hsingchen-dev/LLM-YOLO-Robotic-Arm/Physical Robot/captured_20250410_202952_cup_boxed.jpg

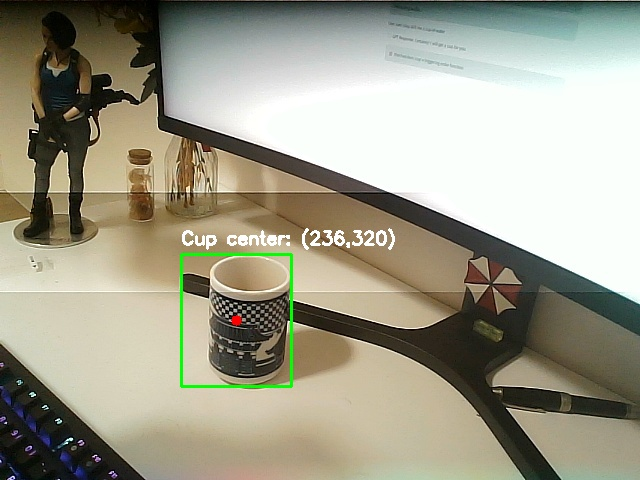
Physical Robot/captured_20250410_202952_cup_boxed.jpg
