hsingchen-dev/LLM-YOLO-Robotic-Arm/Physical Robot/edfa75bb21797ba52d6b21e9edcb2ea.jpg

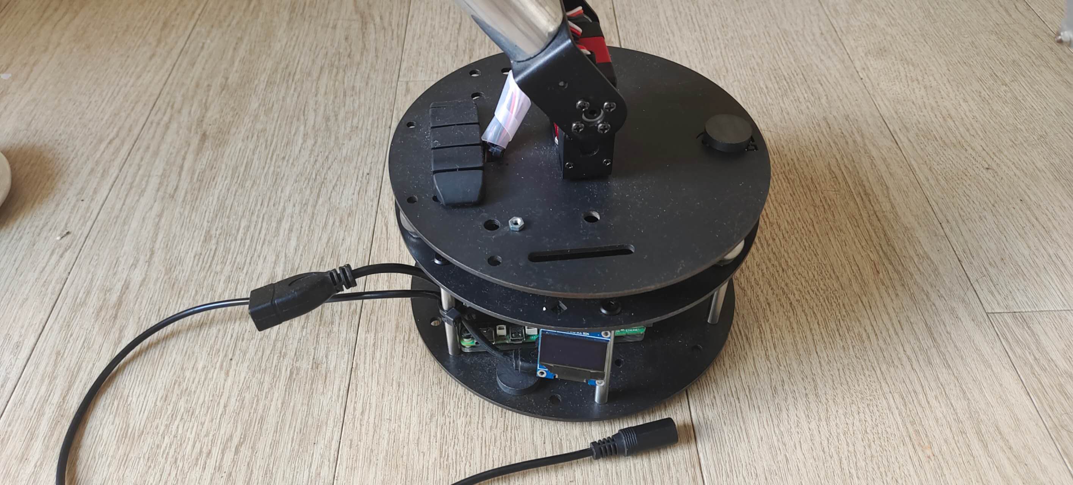
Physical Robot/edfa75bb21797ba52d6b21e9edcb2ea.jpg
