hsingchen-dev/LLM-YOLO-Robotic-Arm/3d图纸/1743786342963.png

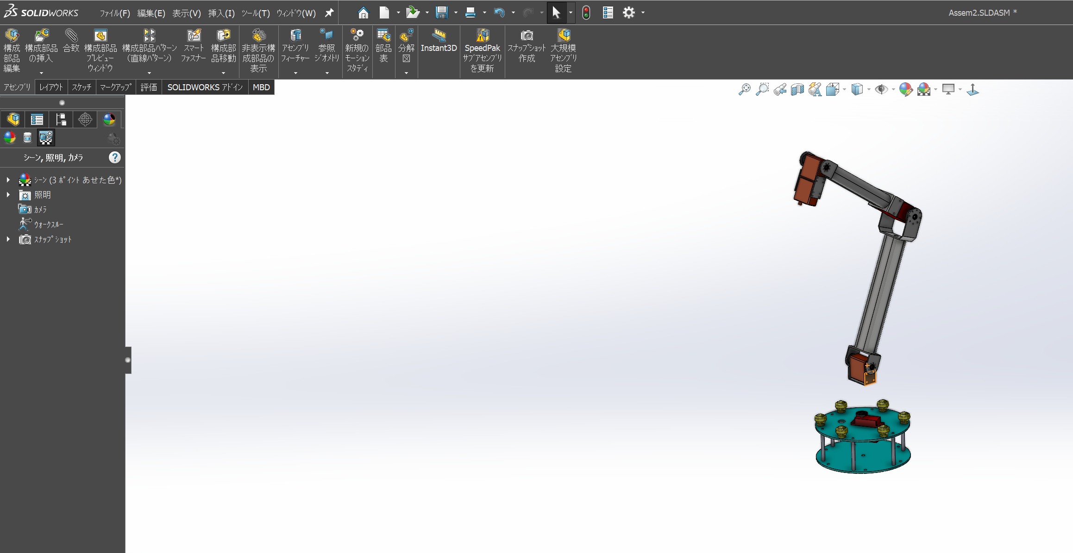
3d图纸/1743786342963.png
