hsingchen-dev/LLM-YOLO-Robotic-Arm/3d图纸/1743786404467.png

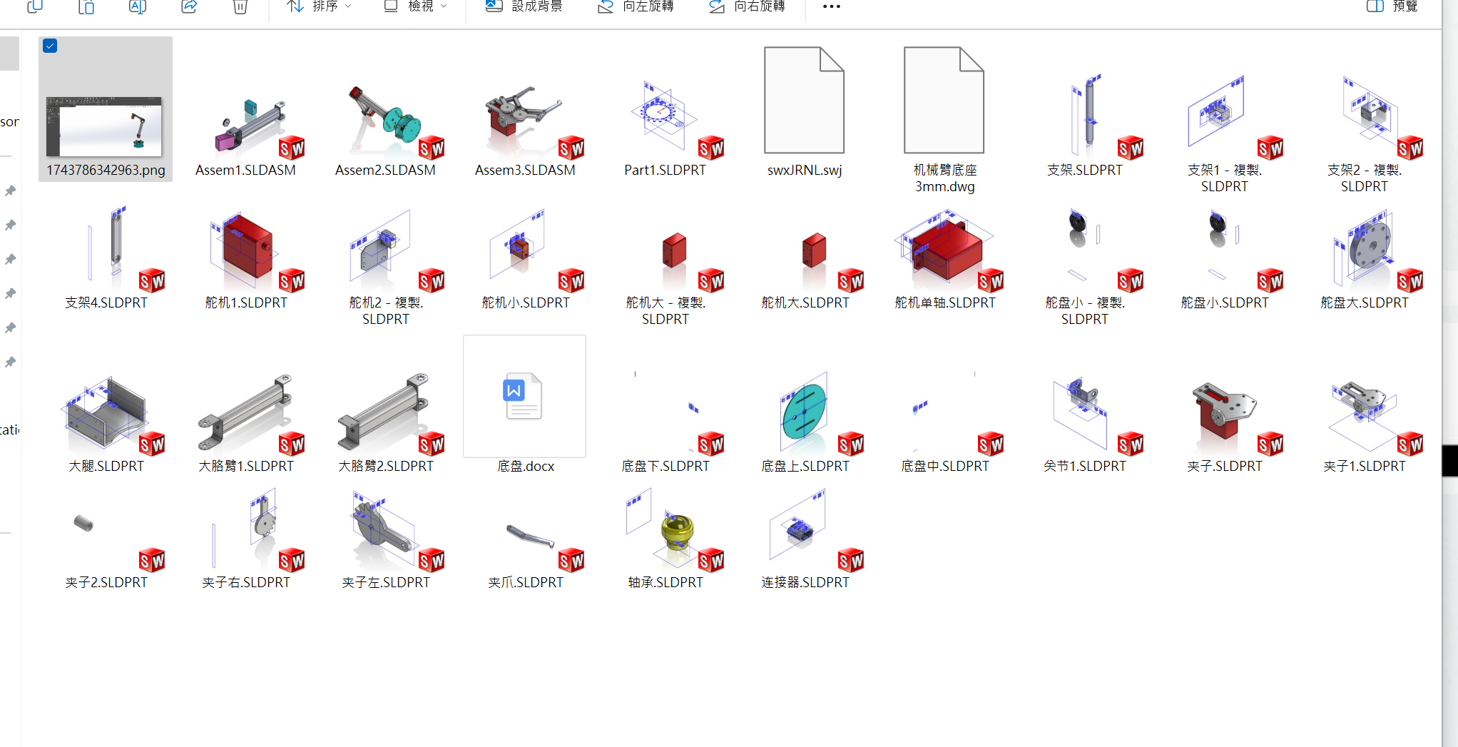
3d图纸/1743786404467.png
