hsingchen-dev/LLM-YOLO-Robotic-Arm/Physical Robot/3e01b9ee80491bdccdec591c8c2af41.jpg

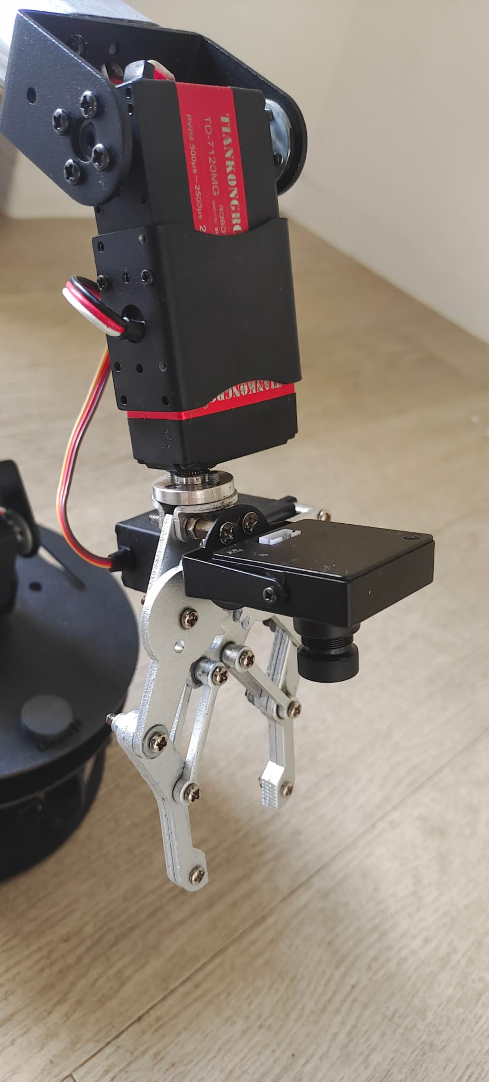
Physical Robot/3e01b9ee80491bdccdec591c8c2af41.jpg
