hsingchen-dev/LLM-YOLO-Robotic-Arm/Physical Robot/8b897eb83b60249cd29b728171771cb.jpg

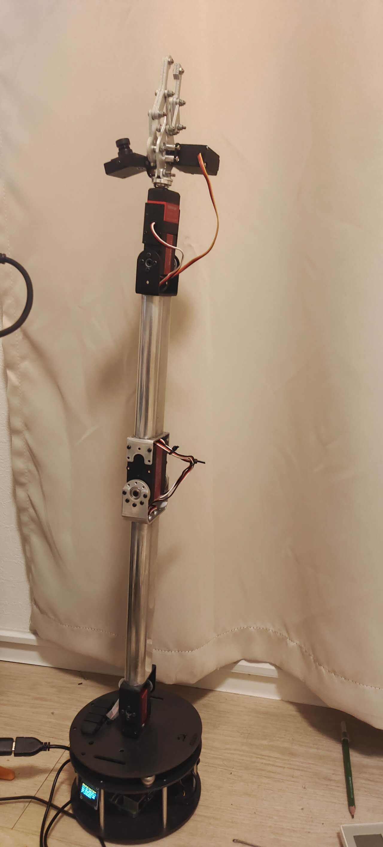
Physical Robot/8b897eb83b60249cd29b728171771cb.jpg
