hsingchen-dev/LLM-YOLO-Robotic-Arm/Physical Robot/5620d81eddff86d6492e32521e1b3c4.jpg

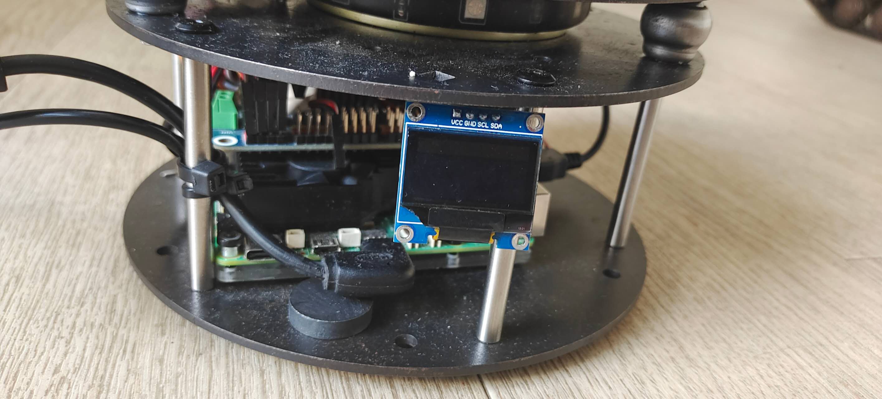
Physical Robot/5620d81eddff86d6492e32521e1b3c4.jpg
