hsingchen-dev/LLM-YOLO-Robotic-Arm/Physical Robot/c2f27f0e20178d3c40c21ab208498a1.jpg

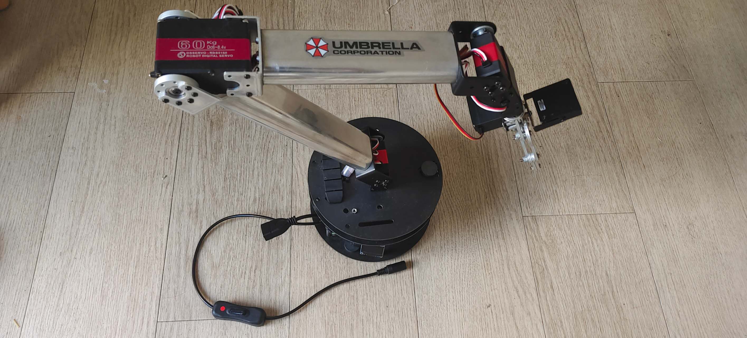
Physical Robot/c2f27f0e20178d3c40c21ab208498a1.jpg
