hsingchen-dev/LLM-YOLO-Robotic-Arm/Physical Robot/c7c526ec436b45697d2431747a68646.jpg

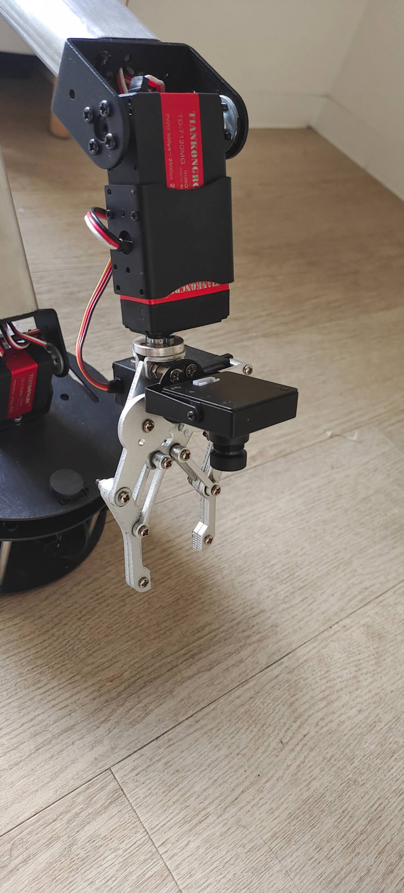
Physical Robot/c7c526ec436b45697d2431747a68646.jpg
