hsingchen-dev/LLM-YOLO-Robotic-Arm/Physical Robot/c12d59ae130f2f59f7dcb45b6c12473.jpg

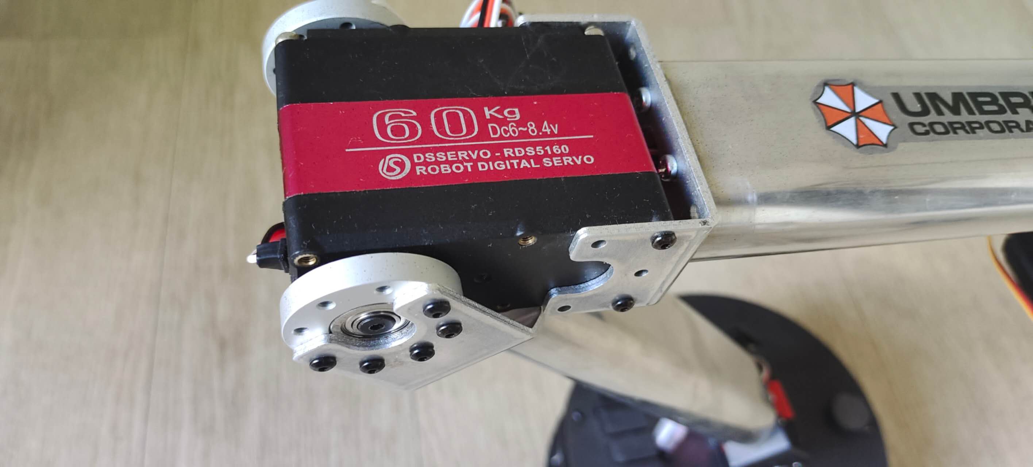
Physical Robot/c12d59ae130f2f59f7dcb45b6c12473.jpg
