hsingchen-dev/LLM-YOLO-Robotic-Arm/Physical Robot/cda66152f0cad378f4611de1aca18b9.png

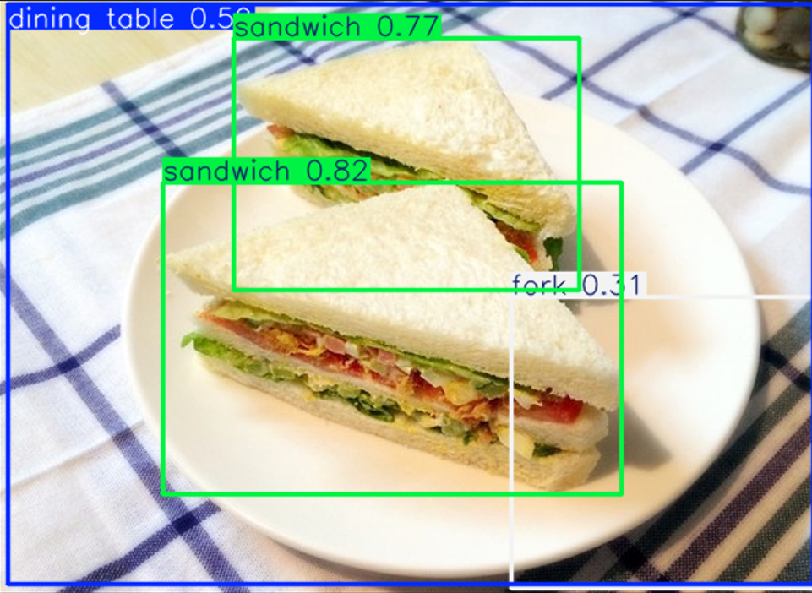
Physical Robot/cda66152f0cad378f4611de1aca18b9.png
