hsingchen-dev/LLM-YOLO-Robotic-Arm/Physical Robot/ee14b7436c1ae5e754dbd46fa025461.jpg

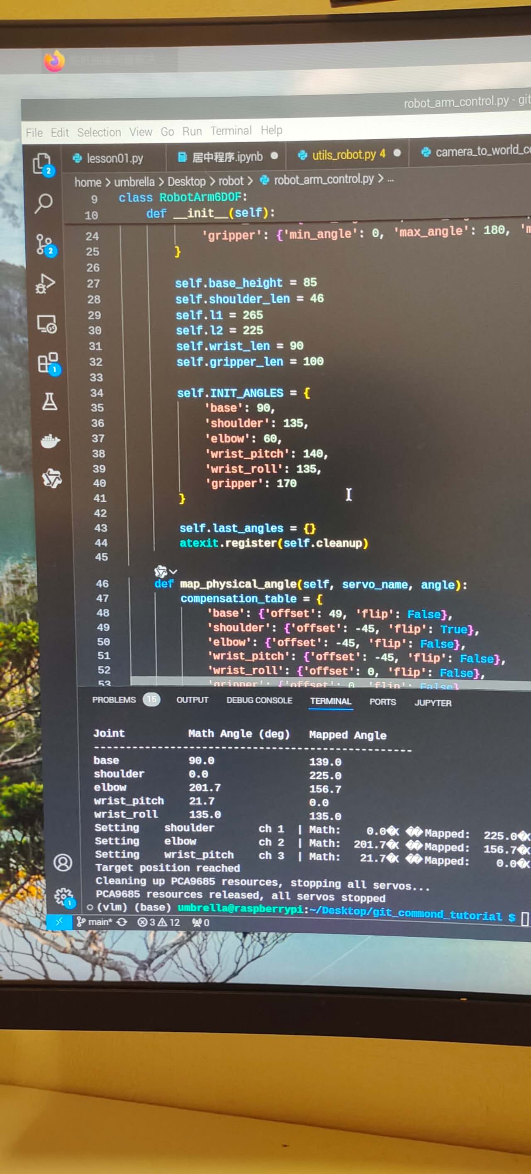
Physical Robot/ee14b7436c1ae5e754dbd46fa025461.jpg
