hsingchen-dev/LLM-YOLO-Robotic-Arm/3d图纸/Assem3.SLDASM

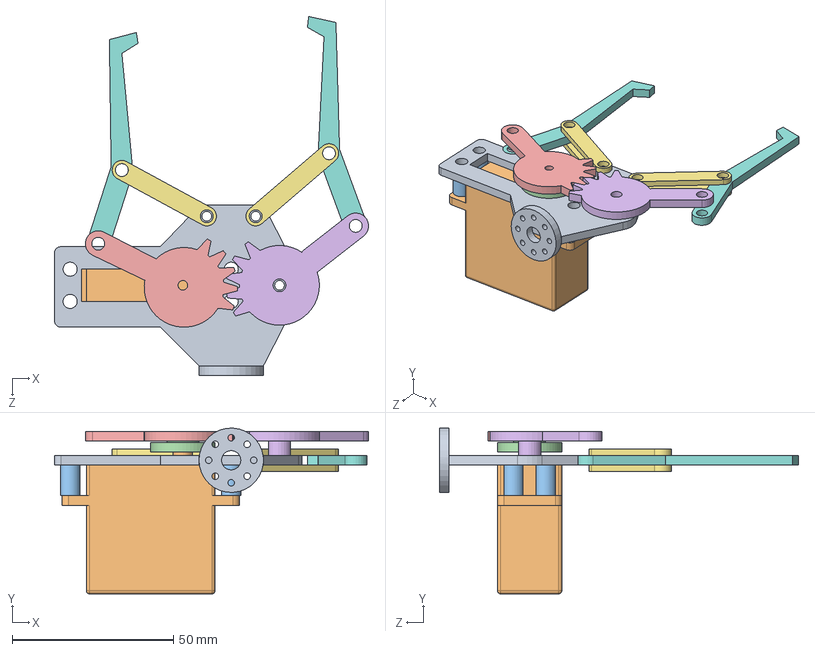
[picture p24: CAD file, 2025-03-27]
3d图纸/Assem3.SLDASM
97.5 x 51.5 x 111.5 mm
夹子1
舵机单轴
夹子2 x 4
舵盘小
夹子右
夹子左
支架4 x 4
夹爪 x 2
