hsingchen-dev/LLM-YOLO-Robotic-Arm/3d图纸/Assem2.SLDASM

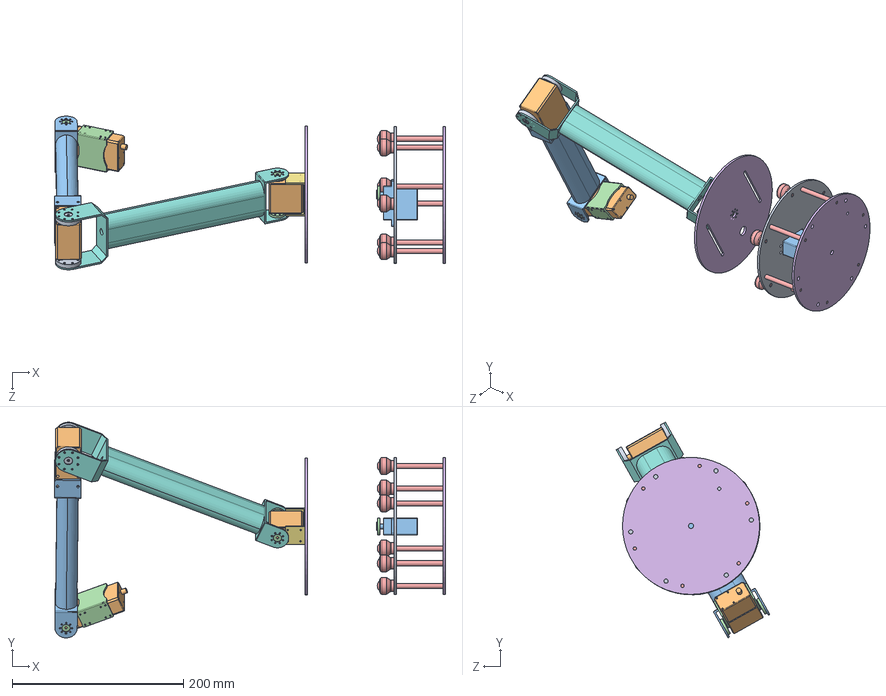
[picture p25: CAD file, 2025-03-27]
3d图纸/Assem2.SLDASM
456.7 x 252.0 x 179.5 mm
底盘中
舵机小 x 3
舵机单轴
舵盘小 x 5
支架 x 6
底盘下
支架1 - 複製
大胳臂1
舵盘大 x 2
舵机大
大胳臂2
大腿
轴承 x 6
底盘上
