hsingchen-dev/LLM-YOLO-Robotic-Arm/3d图纸/Assem1.SLDASM

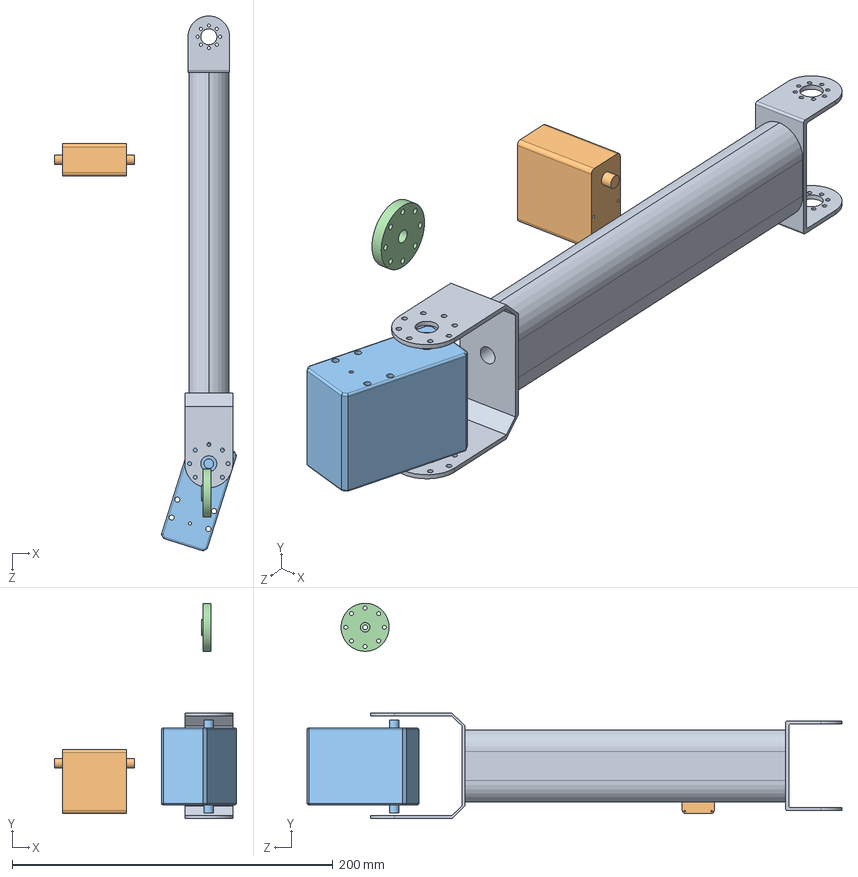
[picture p26: CAD file, 2025-03-27]
3d图纸/Assem1.SLDASM
113.6 x 134.4 x 333.7 mm
大胳臂1
舵机1
舵机大
舵盘大
