hsingchen-dev/LLM-YOLO-Robotic-Arm/3d图纸/大胳臂2.SLDPRT

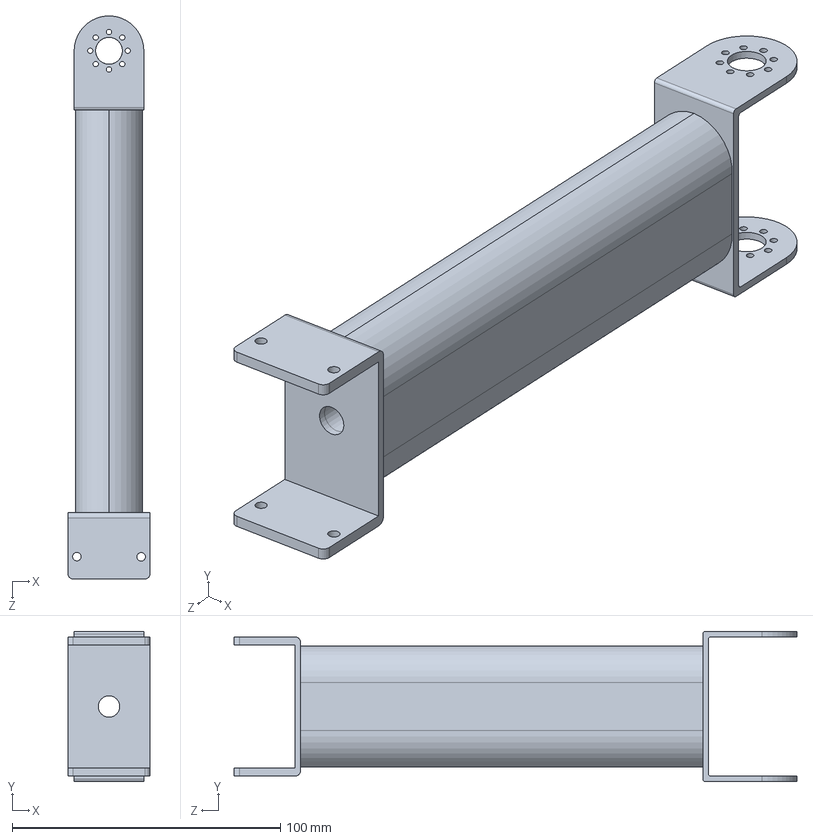
[picture p27: CAD file, 2025-03-27]
3d图纸/大胳臂2.SLDPRT
30.7 x 56.0 x 209.9 mm
