hsingchen-dev/LLM-YOLO-Robotic-Arm/3d图纸/连接器.SLDPRT

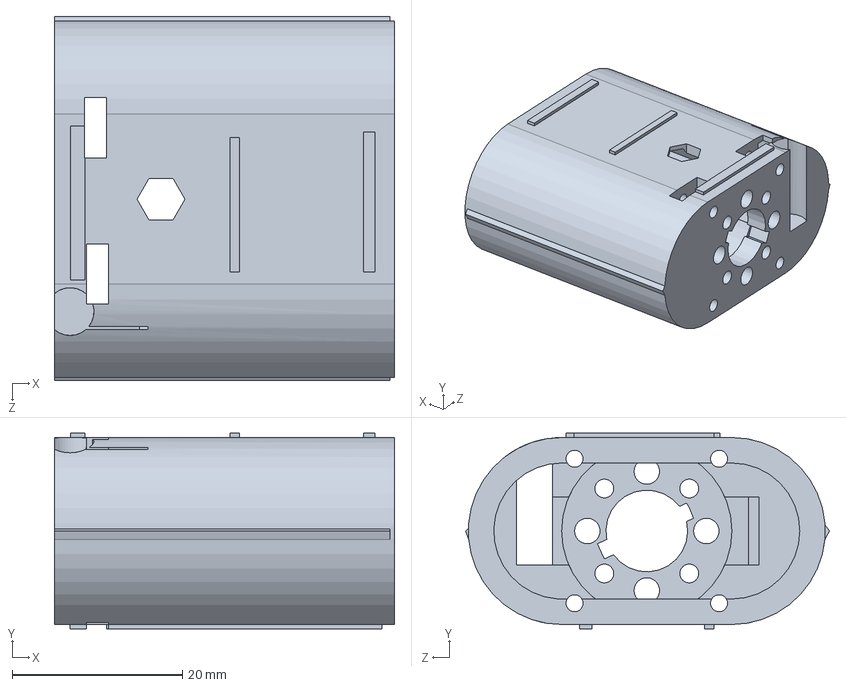
[picture p28: CAD file, 2025-03-27]
3d图纸/连接器.SLDPRT
40.0 x 23.0 x 42.8 mm
