hsingchen-dev/LLM-YOLO-Robotic-Arm/3d图纸/底盘上.SLDPRT

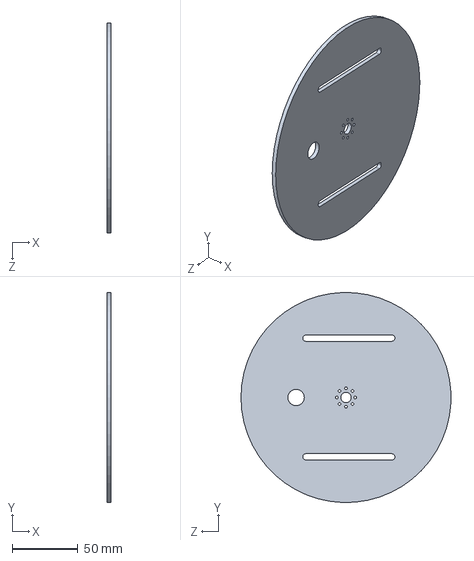
[picture p29: CAD file, 2025-03-27]
3d图纸/底盘上.SLDPRT
3.00 x 159.9 x 160.0 mm
