hsingchen-dev/LLM-YOLO-Robotic-Arm/3d图纸/舵盘小.SLDPRT

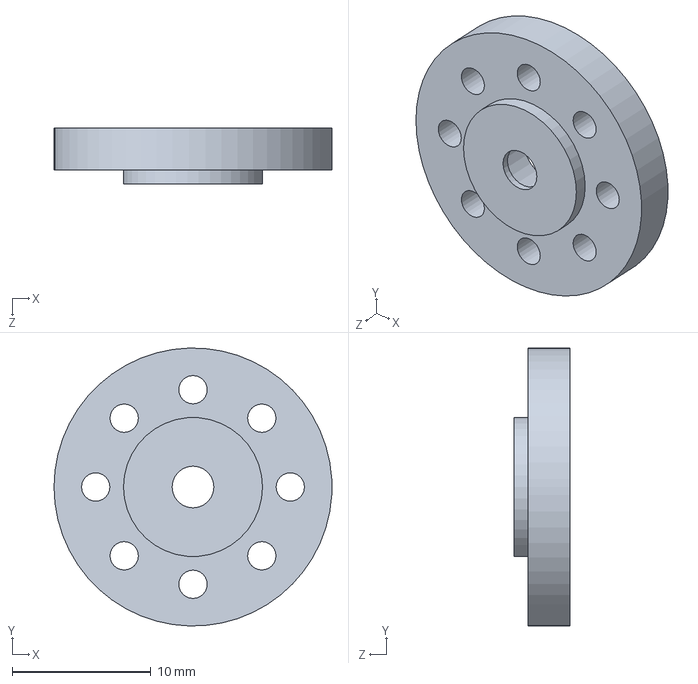
[picture p30: CAD file, 2025-03-27]
3d图纸/舵盘小.SLDPRT
20.0 x 20.0 x 4.00 mm
