hsingchen-dev/LLM-YOLO-Robotic-Arm/3d图纸/夹子左.SLDPRT

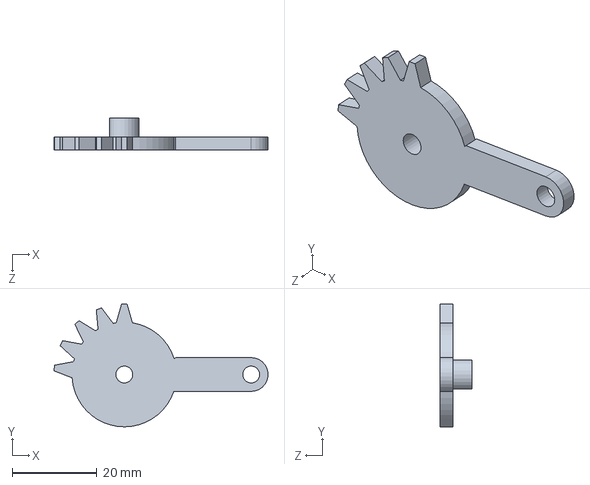
[picture p31: CAD file, 2025-03-27]
3d图纸/夹子左.SLDPRT
50.6 x 29.0 x 7.50 mm
