hsingchen-dev/LLM-YOLO-Robotic-Arm/3d图纸/支架2 - 複製.SLDPRT

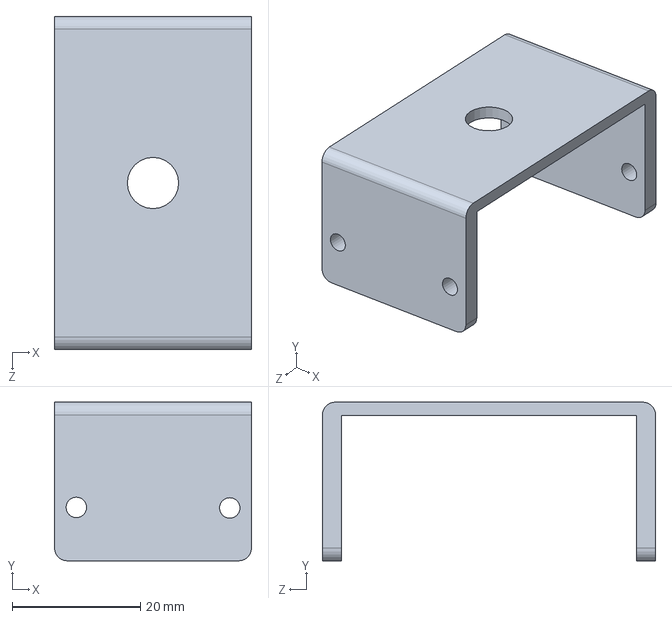
[picture p32: CAD file, 2025-03-27]
3d图纸/支架2 - 複製.SLDPRT
30.7 x 24.8 x 52.0 mm
