hsingchen-dev/LLM-YOLO-Robotic-Arm/3d图纸/夹子.SLDPRT

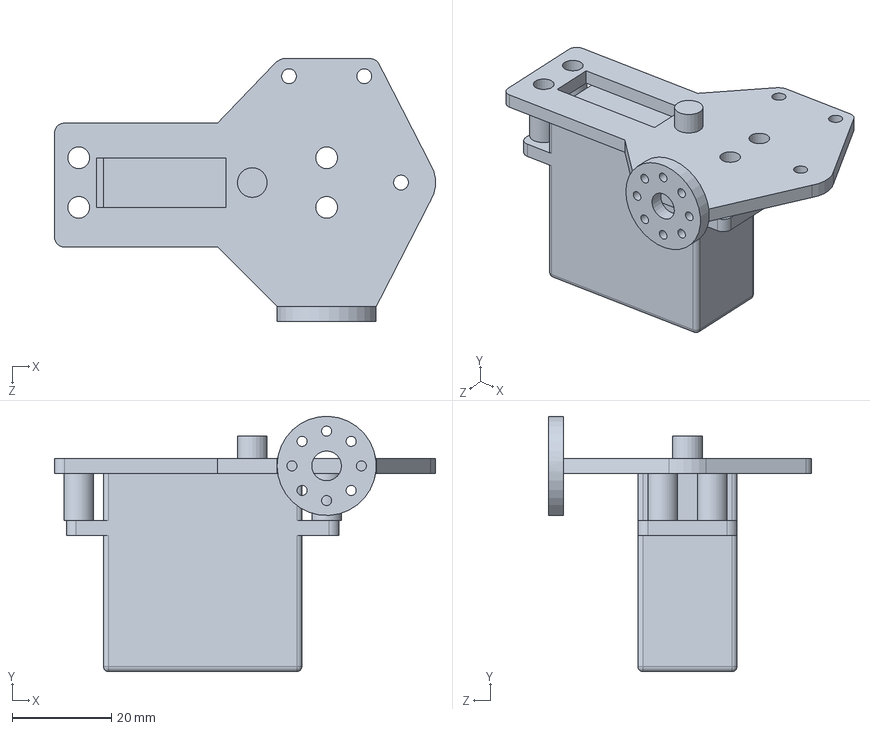
[picture p33: CAD file, 2025-03-27]
3d图纸/夹子.SLDPRT
76.8 x 51.5 x 53.0 mm
