hsingchen-dev/LLM-YOLO-Robotic-Arm/3d图纸/关节1.SLDPRT

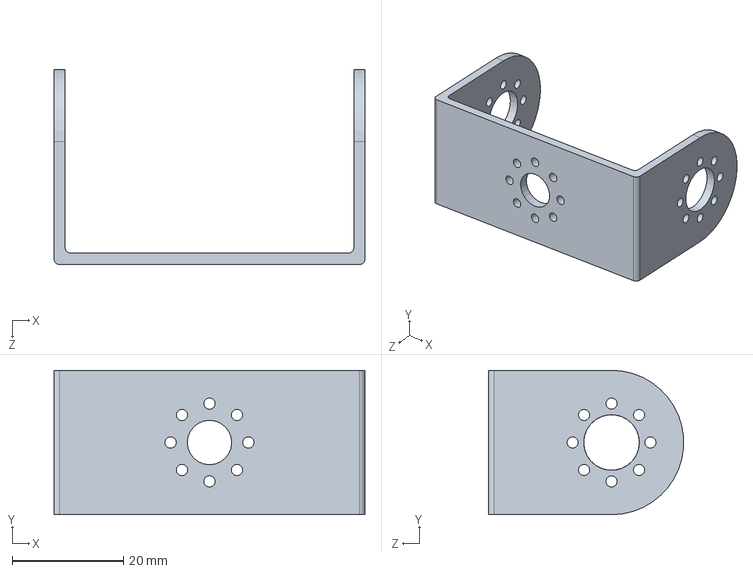
[picture p34: CAD file, 2025-03-27]
3d图纸/关节1.SLDPRT
56.0 x 26.0 x 35.1 mm
