hsingchen-dev/LLM-YOLO-Robotic-Arm/3d图纸/舵机1.SLDPRT

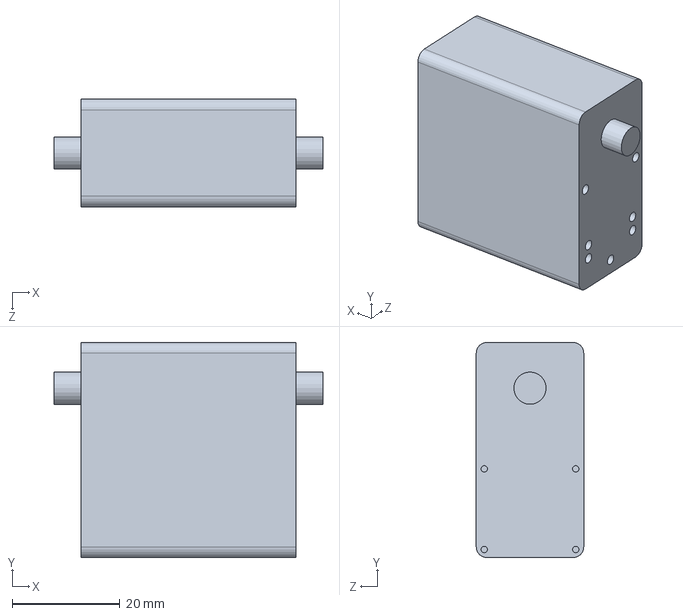
[picture p35: CAD file, 2025-03-27]
3d图纸/舵机1.SLDPRT
50.0 x 40.0 x 20.0 mm
