hsingchen-dev/LLM-YOLO-Robotic-Arm/3d图纸/底盘中.SLDPRT

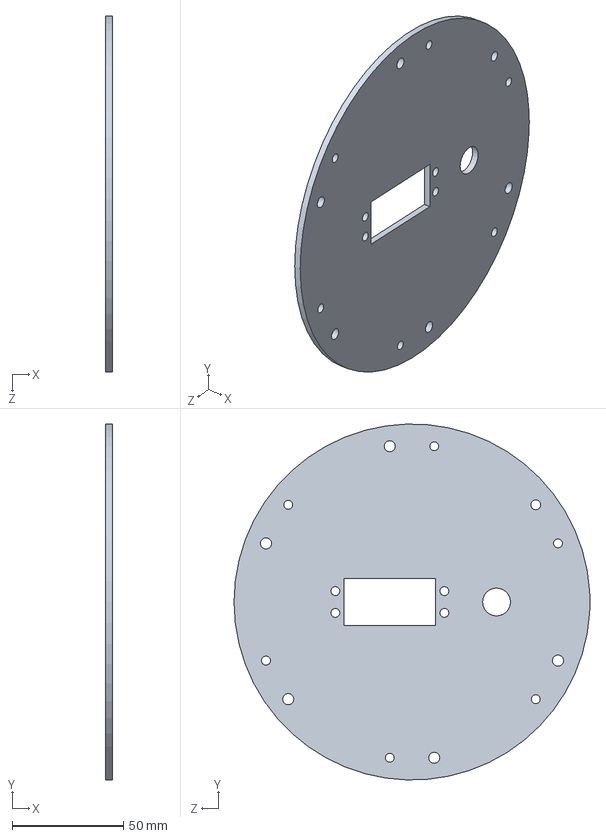
[picture p36: CAD file, 2025-03-27]
3d图纸/底盘中.SLDPRT
3.00 x 159.9 x 160.0 mm
