hsingchen-dev/LLM-YOLO-Robotic-Arm/3d图纸/大胳臂1.SLDPRT

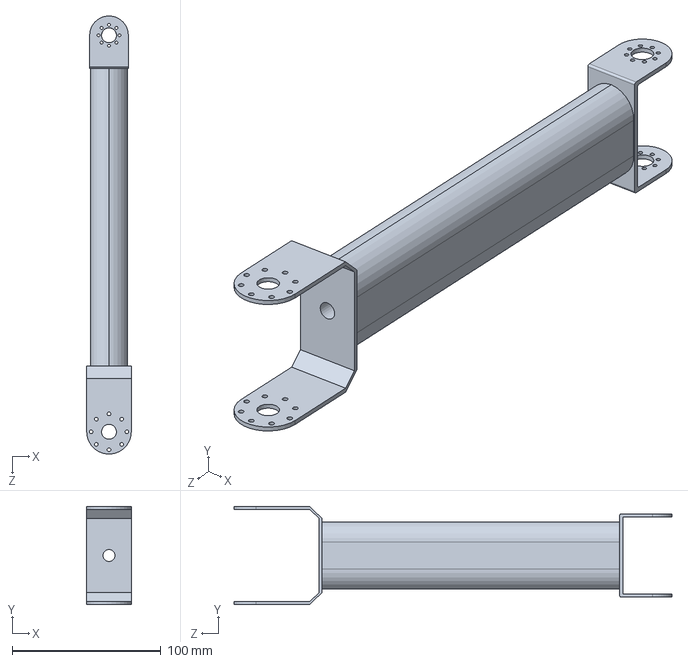
[picture p37: CAD file, 2025-03-27]
3d图纸/大胳臂1.SLDPRT
30.0 x 66.0 x 294.2 mm
