hsingchen-dev/LLM-YOLO-Robotic-Arm/3d图纸/舵盘大.SLDPRT

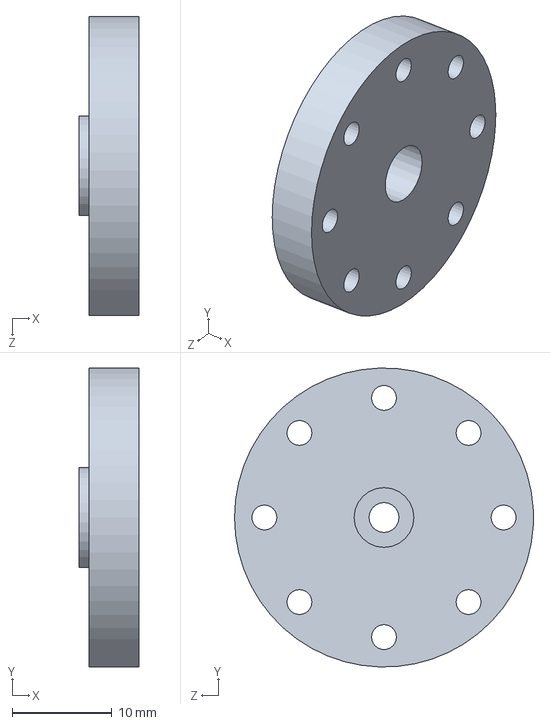
[picture p38: CAD file, 2025-03-27]
3d图纸/舵盘大.SLDPRT
6.00 x 30.0 x 30.0 mm
