hsingchen-dev/LLM-YOLO-Robotic-Arm/3d图纸/轴承.SLDPRT

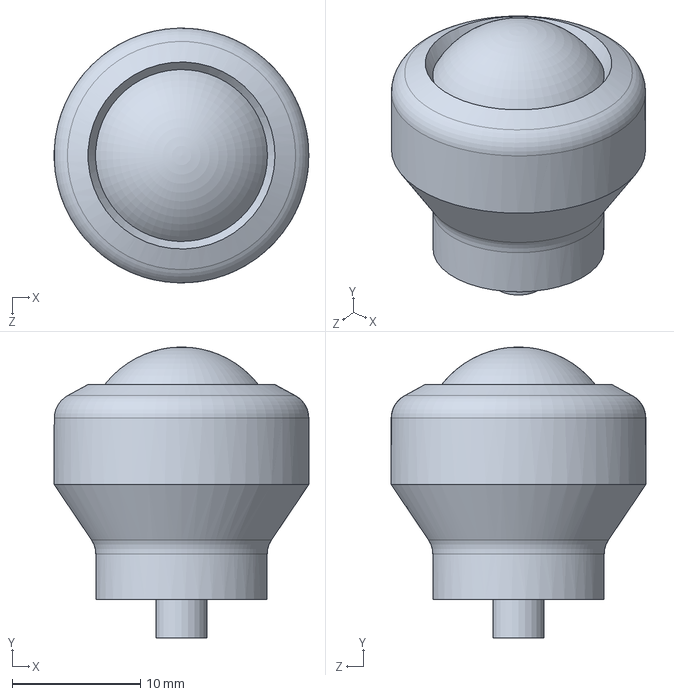
[picture p39: CAD file, 2025-03-27]
3d图纸/轴承.SLDPRT
19.9 x 22.7 x 19.9 mm
