hsingchen-dev/LLM-YOLO-Robotic-Arm/3d图纸/支架4.SLDPRT

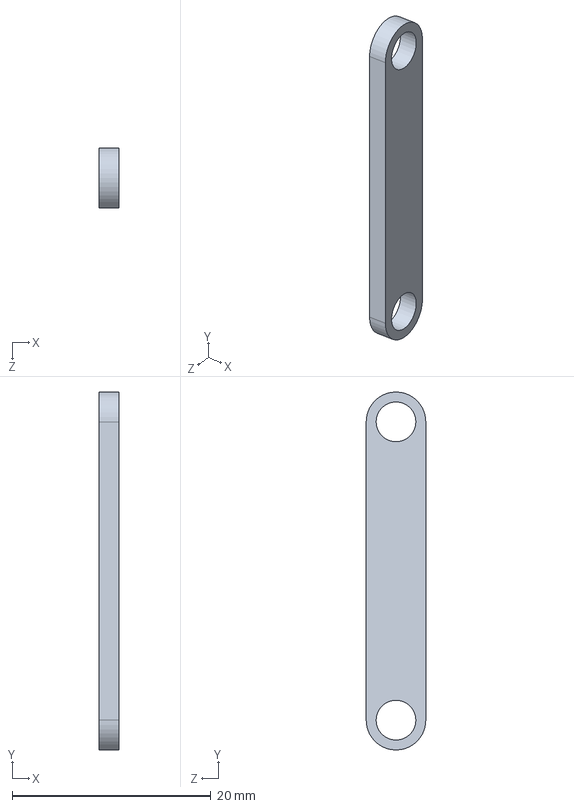
[picture p40: CAD file, 2025-03-27]
3d图纸/支架4.SLDPRT
2.00 x 36.0 x 6.00 mm
