hsingchen-dev/LLM-YOLO-Robotic-Arm/3d图纸/舵机小.SLDPRT

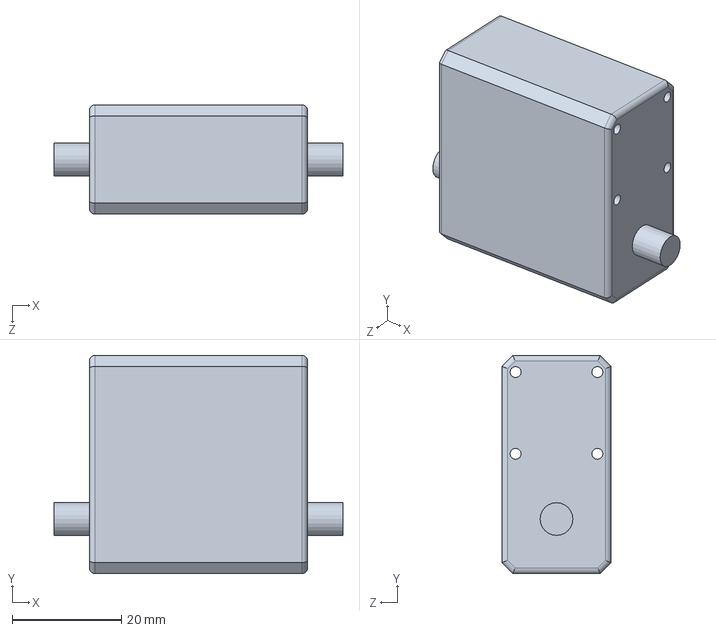
[picture p41: CAD file, 2025-03-27]
3d图纸/舵机小.SLDPRT
53.0 x 40.0 x 20.0 mm
