hsingchen-dev/LLM-YOLO-Robotic-Arm/3d图纸/大腿.SLDPRT

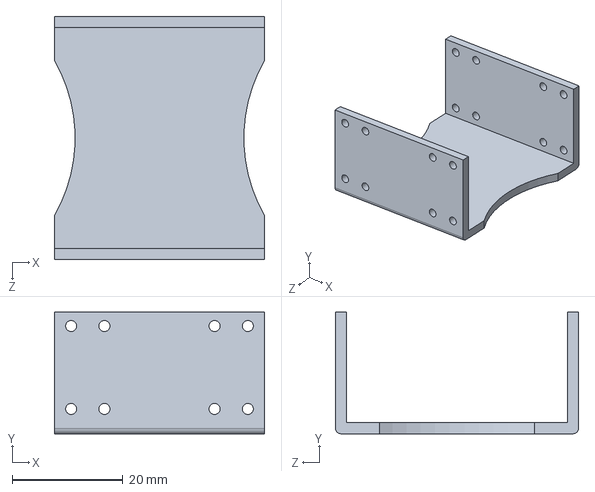
[picture p42: CAD file, 2025-03-27]
3d图纸/大腿.SLDPRT
38.0 x 22.0 x 44.0 mm
