hsingchen-dev/LLM-YOLO-Robotic-Arm/3d图纸/支架1 - 複製.SLDPRT

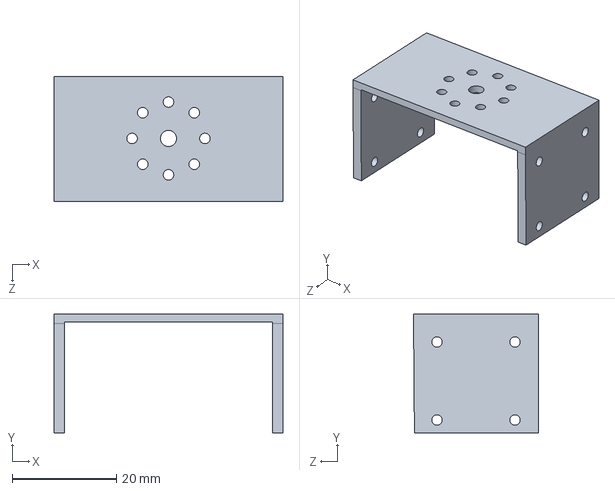
[picture p43: CAD file, 2025-03-27]
3d图纸/支架1 - 複製.SLDPRT
44.0 x 22.8 x 24.0 mm
