hsingchen-dev/LLM-YOLO-Robotic-Arm/3d图纸/底盘下.SLDPRT

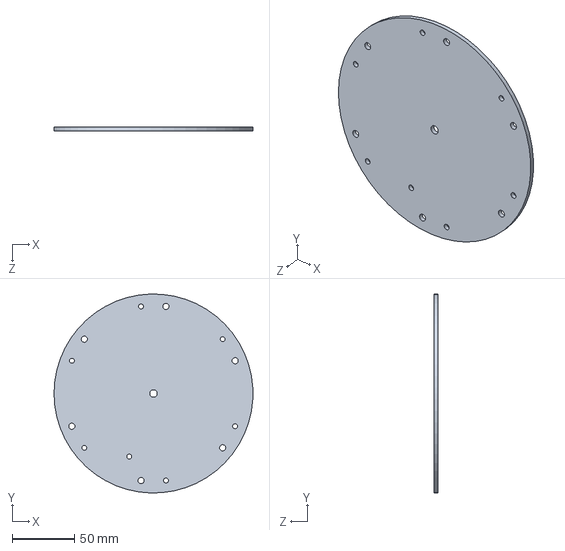
[picture p44: CAD file, 2025-03-27]
3d图纸/底盘下.SLDPRT
160.0 x 159.9 x 3.00 mm
