hsingchen-dev/LLM-YOLO-Robotic-Arm/3d图纸/舵机2 - 複製.SLDPRT

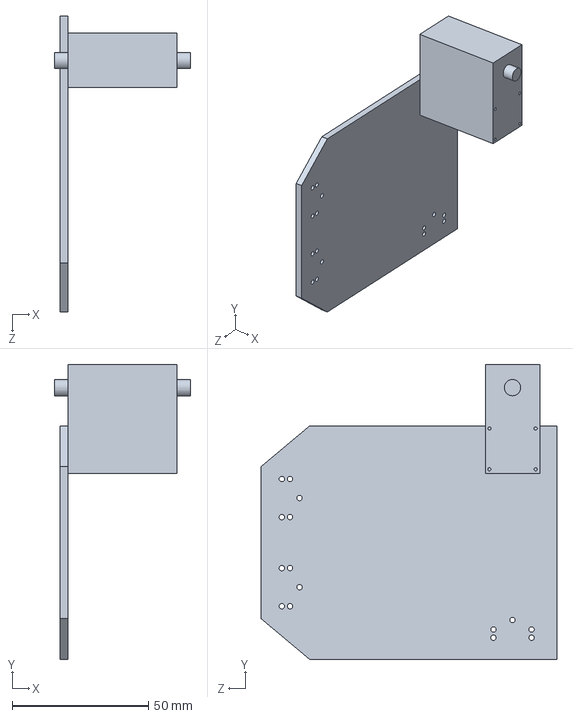
[picture p45: CAD file, 2025-03-27]
3d图纸/舵机2 - 複製.SLDPRT
50.0 x 108.3 x 108.7 mm
