hsingchen-dev/LLM-YOLO-Robotic-Arm/3d图纸/支架.SLDPRT

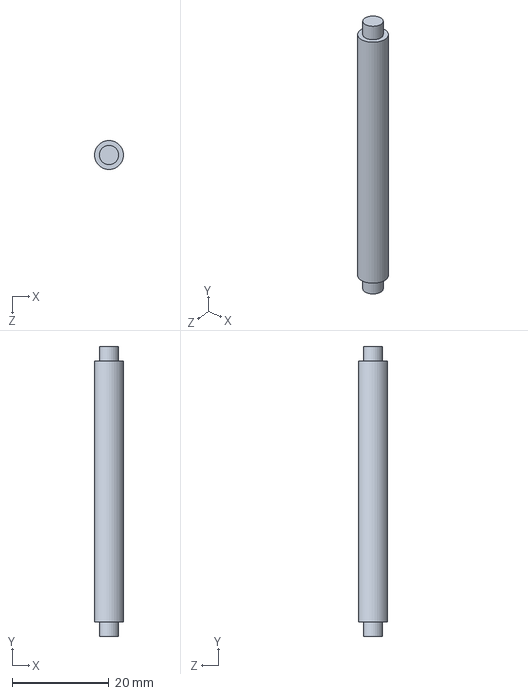
[picture p46: CAD file, 2025-03-27]
3d图纸/支架.SLDPRT
5.97 x 60.0 x 6.00 mm
