hsingchen-dev/LLM-YOLO-Robotic-Arm/3d图纸/舵机大.SLDPRT

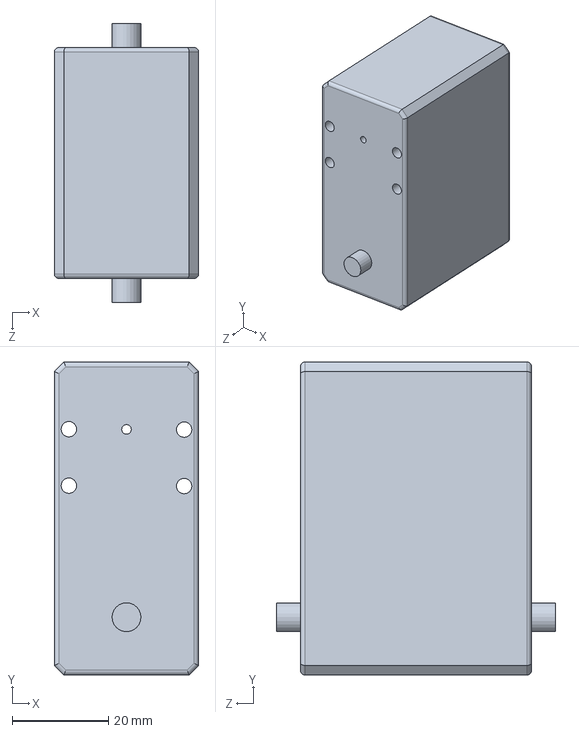
[picture p47: CAD file, 2025-03-27]
3d图纸/舵机大.SLDPRT
30.0 x 65.0 x 58.0 mm
