hsingchen-dev/LLM-YOLO-Robotic-Arm/3d图纸/夹子右.SLDPRT

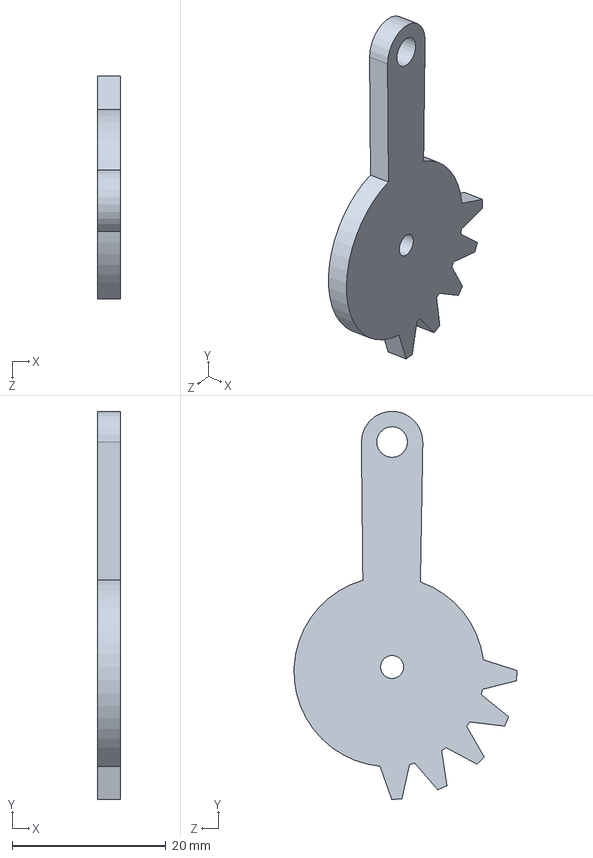
[picture p48: CAD file, 2025-03-27]
3d图纸/夹子右.SLDPRT
3.00 x 50.5 x 29.0 mm
