hsingchen-dev/LLM-YOLO-Robotic-Arm/3d图纸/舵机单轴.SLDPRT

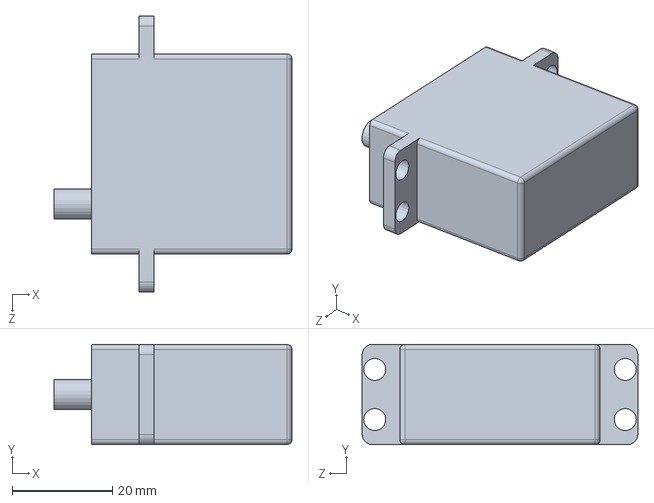
[picture p49: CAD file, 2025-03-27]
3d图纸/舵机单轴.SLDPRT
47.5 x 20.0 x 55.0 mm
