hsingchen-dev/LLM-YOLO-Robotic-Arm/3d图纸/夹子2.SLDPRT

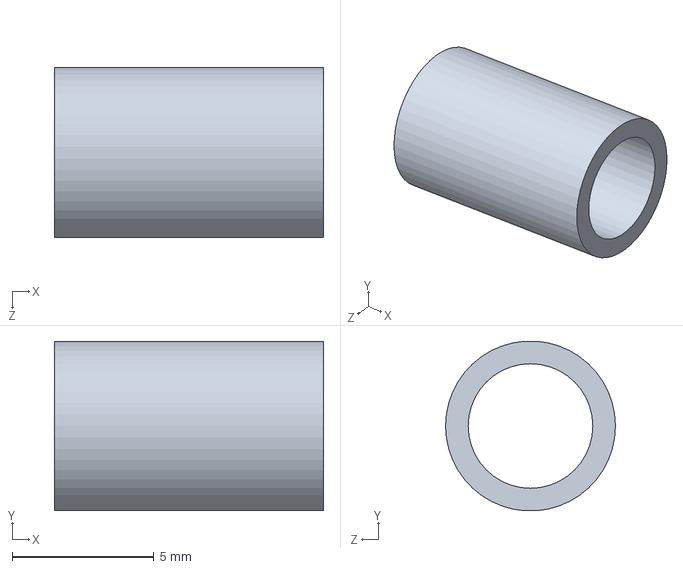
[picture p50: CAD file, 2025-03-27]
3d图纸/夹子2.SLDPRT
9.50 x 5.99 x 6.00 mm
