hsingchen-dev/LLM-YOLO-Robotic-Arm/3d图纸/夹子1.SLDPRT

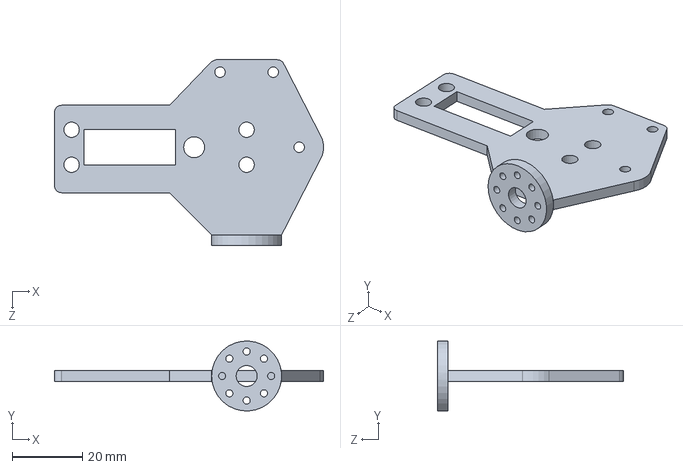
[picture p51: CAD file, 2025-03-27]
3d图纸/夹子1.SLDPRT
76.8 x 20.0 x 53.0 mm
