hsingchen-dev/LLM-YOLO-Robotic-Arm/3d图纸/夹爪.SLDPRT

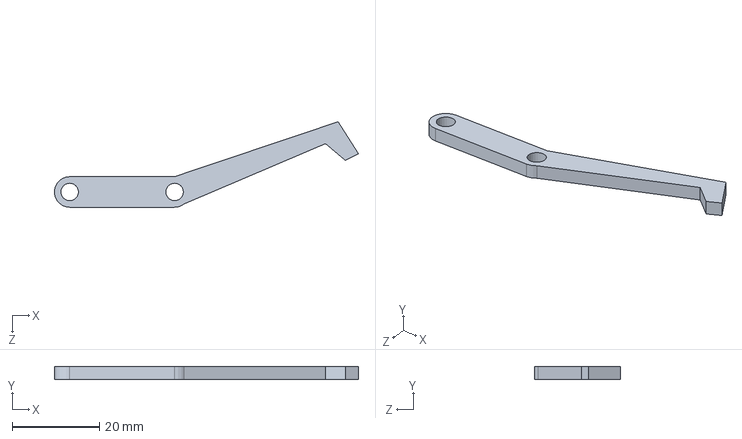
[picture p52: CAD file, 2025-03-27]
3d图纸/夹爪.SLDPRT
69.5 x 3.00 x 19.6 mm
