hsingchen-dev/LLM-YOLO-Robotic-Arm/(list of files, cad)

Other CAD files:
3d图纸/Part1.SLDPRT
3d图纸/舵盘小 - 複製.SLDPRT
3d图纸/机械臂底座3mm.dwg
