hsingchen-dev/LLM-YOLO-Robotic-Arm/(commit log)

2025-03-27 Add YOLO model weights and test notebook
    Includes:
    - yolov5n checkpoint for object detection
    - yolov inference notebook (testing with robotic arm vision)
2025-03-27 Add inverse kinematics testing
    - `kinematics.py`: core IK solver
    - `configuration.py`: joint/arm parameters
    - `visualise_robot.ipynb`: simple 3D visualization of IK results
    - `机器人测试逆运动学.ipynb`: test notebook with example configurations
    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
2025-03-27 3D drawings
    The SolidWorks CAD models in this project were designed by Mr. Hang based on off-the-shelf components sourced from Taobao.
    The chassis is made of laser-cut stainless steel, and the robotic arm uses aluminum tubing with 3D printed connectors.
    Please note that certain 3D printed parts may lack mechanical strength and are intended primarily for prototyping and demonstration purposes.
    [Assem1.SLDASM, Assem2.SLDASM, Assem3.SLDASM, Part1.SLDPRT, 关节1.SLDPRT, 大胳臂1.SLDPRT, 大胳臂2.SLDPRT, 大腿.SLDPRT]
2025-04-13 Delete プロジェクト企画書.pptx
    Delete old proposal PPT
